dioxygen/MIPS_CPU/verilog/VIVADO_MIPS_CPU/MIPS_CPU.runs/impl_1/.init_design.begin.rst

<?xml version="1.0"?>
<ProcessHandle Version="1" Minor="0">
    <Process Command=".planAhead." Owner="YANGQING" Host="YQ" Pid="9220">
    </Process>
</ProcessHandle>
