dioxygen/MIPS_CPU/verilog/VIVADO_MIPS_CPU/MIPS_CPU.runs/impl_1/.vivado.begin.rst

<?xml version="1.0"?>
<ProcessHandle Version="1" Minor="0">
    <Process Command="vivado.bat" Owner="YANGQING" Host="YQ" Pid="11488">
    </Process>
</ProcessHandle>
