dioxygen/MIPS_CPU/logisim/测试用例/benchmark.txt

v2.0 raw
ae330000
ae140000
ae330000
ae140000
