dioxygen/MIPS_CPU/(list of files, drawings)

Other design files:
logisim/logisim_74v1/7442.circ
logisim/logisim_74v1/7442v2.circ
logisim/logisim_74v1/7451.circ
logisim/logisim_74v1/7474.circ
logisim/logisim_74v1/7476.circ
logisim/logisim_74v1/74109.circ
logisim/logisim_74v1/74138.circ
logisim/logisim_74v1/74147.circ
logisim/logisim_74v1/74148.circ
logisim/logisim_74v1/74151.circ
logisim/logisim_74v1/74154.circ
logisim/logisim_74v1/74157.circ
logisim/logisim_74v1/74160.circ
logisim/logisim_74v1/74163.circ
logisim/logisim_74v1/74163v2.circ
logisim/logisim_74v1/74164.circ
logisim/logisim_74v1/74165.circ
logisim/logisim_74v1/74166.circ
logisim/logisim_74v1/74173.circ
logisim/logisim_74v1/74181 v3.circ
logisim/logisim_74v1/74182.circ
logisim/logisim_74v1/74193.circ
logisim/logisim_74v1/74273.circ
logisim/logisim_74v1/74374.circ
logisim/logisim_74v1/74385.circ
logisim/logisim_74v1/74670.circ
logisim/五段流水支持中断CPU/CS1409_U201414810_杨卿_alu.circ
logisim/五段流水支持中断CPU/CS1409_U201414810_杨卿_regfile-1.circ
logisim/五段流水支持中断CPU/流水中断_MIPS_CPU .circ
