dioxygen/MIPS_CPU/verilog/VIVADO_MIPS_CPU/MIPS_CPU.srcs/constrs_1/new/yingjiao.xdc

set_property CLOCK_DEDICATED_ROUTE FALSE [get_nets ExpSrc1_IBUF]
set_property CLOCK_DEDICATED_ROUTE FALSE [get_nets ExpSrc2_IBUF]
set_property CLOCK_DEDICATED_ROUTE FALSE [get_nets ExpSrc3_IBUF]

set_property PACKAGE_PIN N6 [get_ports anodes[0]]
set_property IOSTANDARD LVCMOS33 [get_ports anodes[0]]
set_property PACKAGE_PIN M6 [get_ports anodes[1]]
set_property IOSTANDARD LVCMOS33 [get_ports anodes[1]]
set_property PACKAGE_PIN M3 [get_ports anodes[2]]
set_property IOSTANDARD LVCMOS33 [get_ports anodes[2]]
set_property PACKAGE_PIN N5 [get_ports anodes[3]]
set_property IOSTANDARD LVCMOS33 [get_ports anodes[3]]
set_property PACKAGE_PIN N2 [get_ports anodes[4]]
set_property IOSTANDARD LVCMOS33 [get_ports anodes[4]]
set_property PACKAGE_PIN N4 [get_ports anodes[5]]
set_property IOSTANDARD LVCMOS33 [get_ports anodes[5]]
set_property PACKAGE_PIN L1 [get_ports anodes[6]]
set_property IOSTANDARD LVCMOS33 [get_ports anodes[6]]
set_property PACKAGE_PIN M1 [get_ports anodes[7]]
set_property IOSTANDARD LVCMOS33 [get_ports anodes[7]]

set_property PACKAGE_PIN L3 [get_ports cnodes[0]]
set_property IOSTANDARD LVCMOS33 [get_ports cnodes[0]]
set_property PACKAGE_PIN N1 [get_ports cnodes[1]]
set_property IOSTANDARD LVCMOS33 [get_ports cnodes[1]]
set_property PACKAGE_PIN L5 [get_ports cnodes[2]]
set_property IOSTANDARD LVCMOS33 [get_ports cnodes[2]]
set_property PACKAGE_PIN L4 [get_ports cnodes[3]]
set_property IOSTANDARD LVCMOS33 [get_ports cnodes[3]]
set_property PACKAGE_PIN K3 [get_ports cnodes[4]]
set_property IOSTANDARD LVCMOS33 [get_ports cnodes[4]]
set_property PACKAGE_PIN M2 [get_ports cnodes[5]]
set_property IOSTANDARD LVCMOS33 [get_ports cnodes[5]]
set_property PACKAGE_PIN L6 [get_ports cnodes[6]]
set_property IOSTANDARD LVCMOS33 [get_ports cnodes[6]]
set_property PACKAGE_PIN M4 [get_ports cnodes[7]]
set_property IOSTANDARD LVCMOS33 [get_ports cnodes[7]]
set_property PACKAGE_PIN E3 [get_ports clk_sys]
set_property IOSTANDARD LVCMOS18 [get_ports clk_sys]

set_property PACKAGE_PIN T16 [get_ports ExpSrc1]
set_property IOSTANDARD LVCMOS18 [get_ports ExpSrc1]
set_property PACKAGE_PIN E16 [get_ports ExpSrc2]
set_property IOSTANDARD LVCMOS18 [get_ports ExpSrc2]
set_property PACKAGE_PIN R10 [get_ports ExpSrc3]
set_property IOSTANDARD LVCMOS18 [get_ports ExpSrc3]
